filip-we/6502/etc/the_computer_20210620.jpg

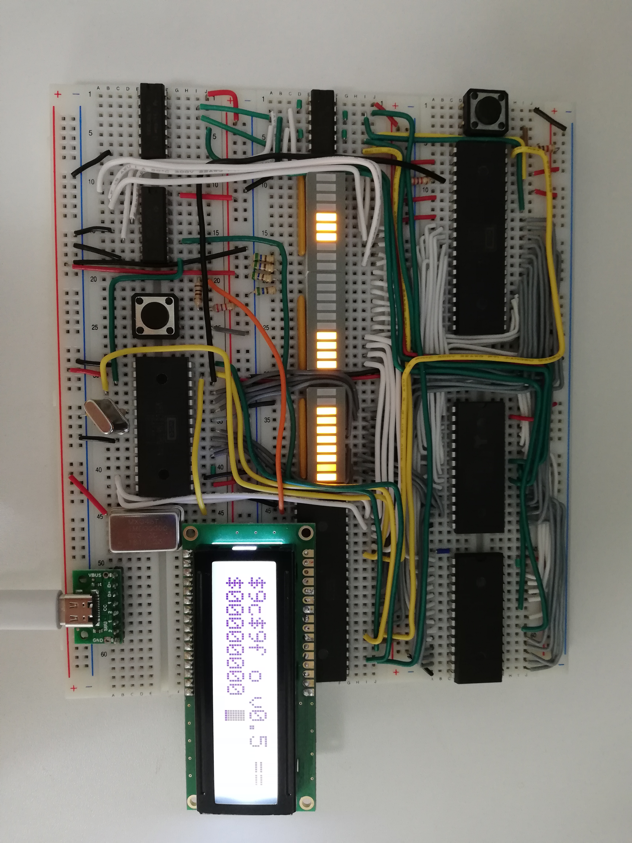
etc/the_computer_20210620.jpg
