filip-we/6502/eeprom/eeprom_prog.png

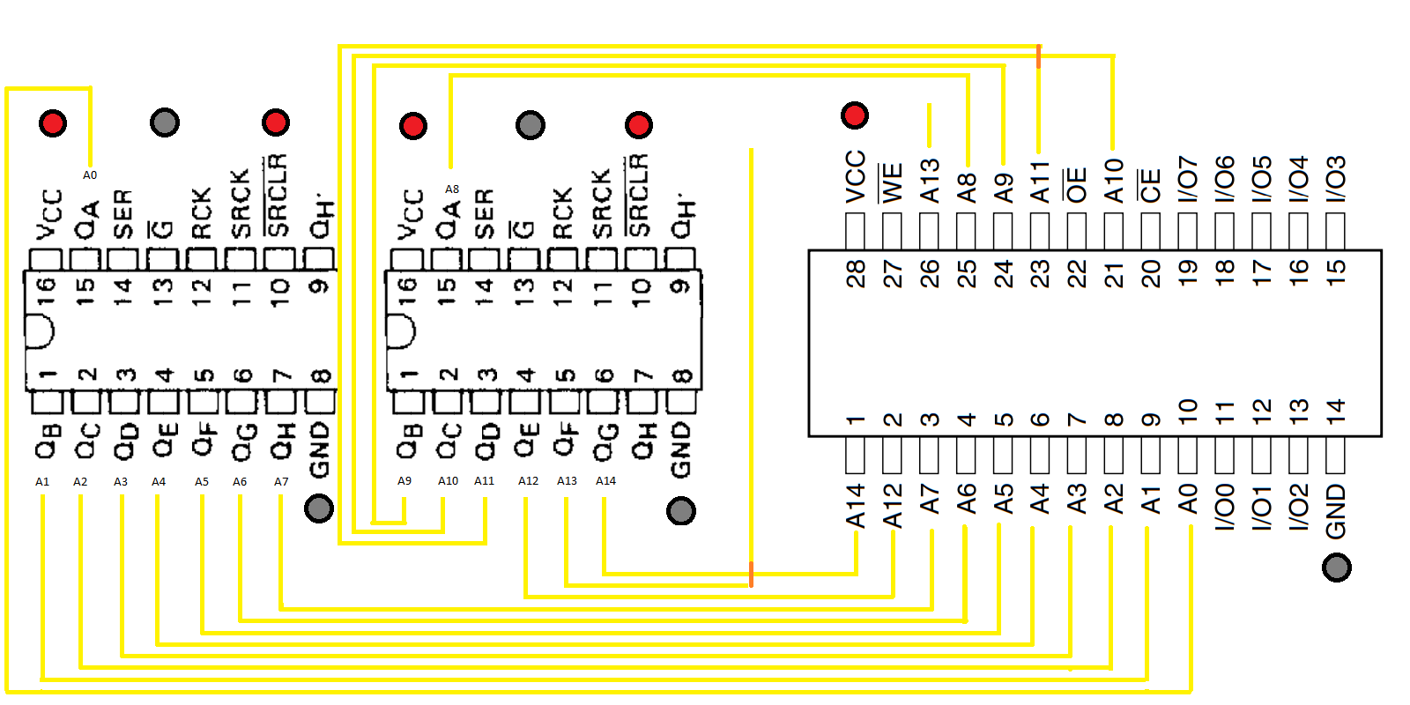
eeprom/eeprom_prog.png
