filip-we/6502/etc/pcb/6502_test/6502_test.kicad_pcb

## KiCad design LM3886_servo.sch

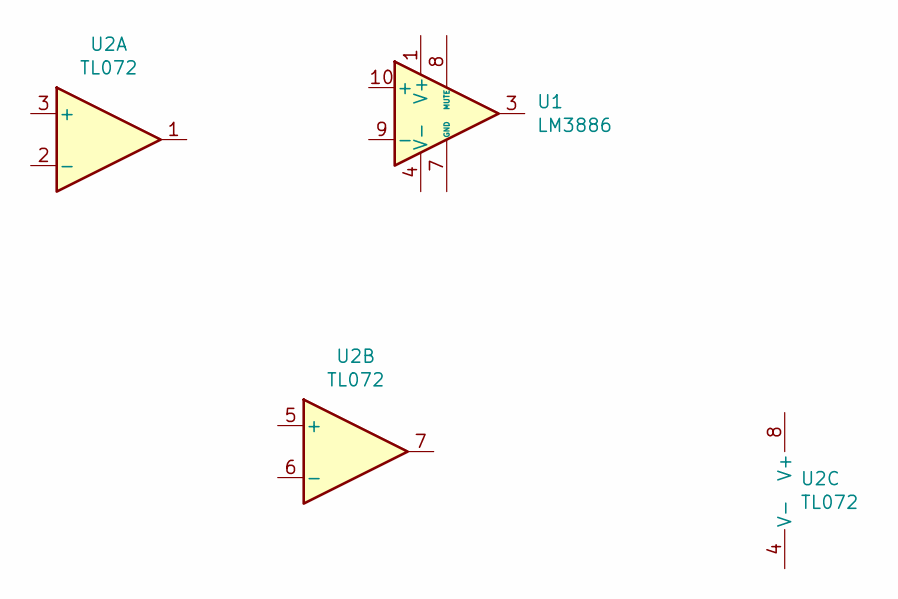
[picture p3: schematic LM3886_servo.sch]

Parts:
U1: LM3886; TO-220-11_P3.4x5.08mm_StaggerOdd_Lead4.85mm_Vertical
U2: TL072

Connections:
unnamed: U1.1 (V+), U1.5 (V+)
