filip-we/6502/eeprom/eeprom_schematic_soldered.png

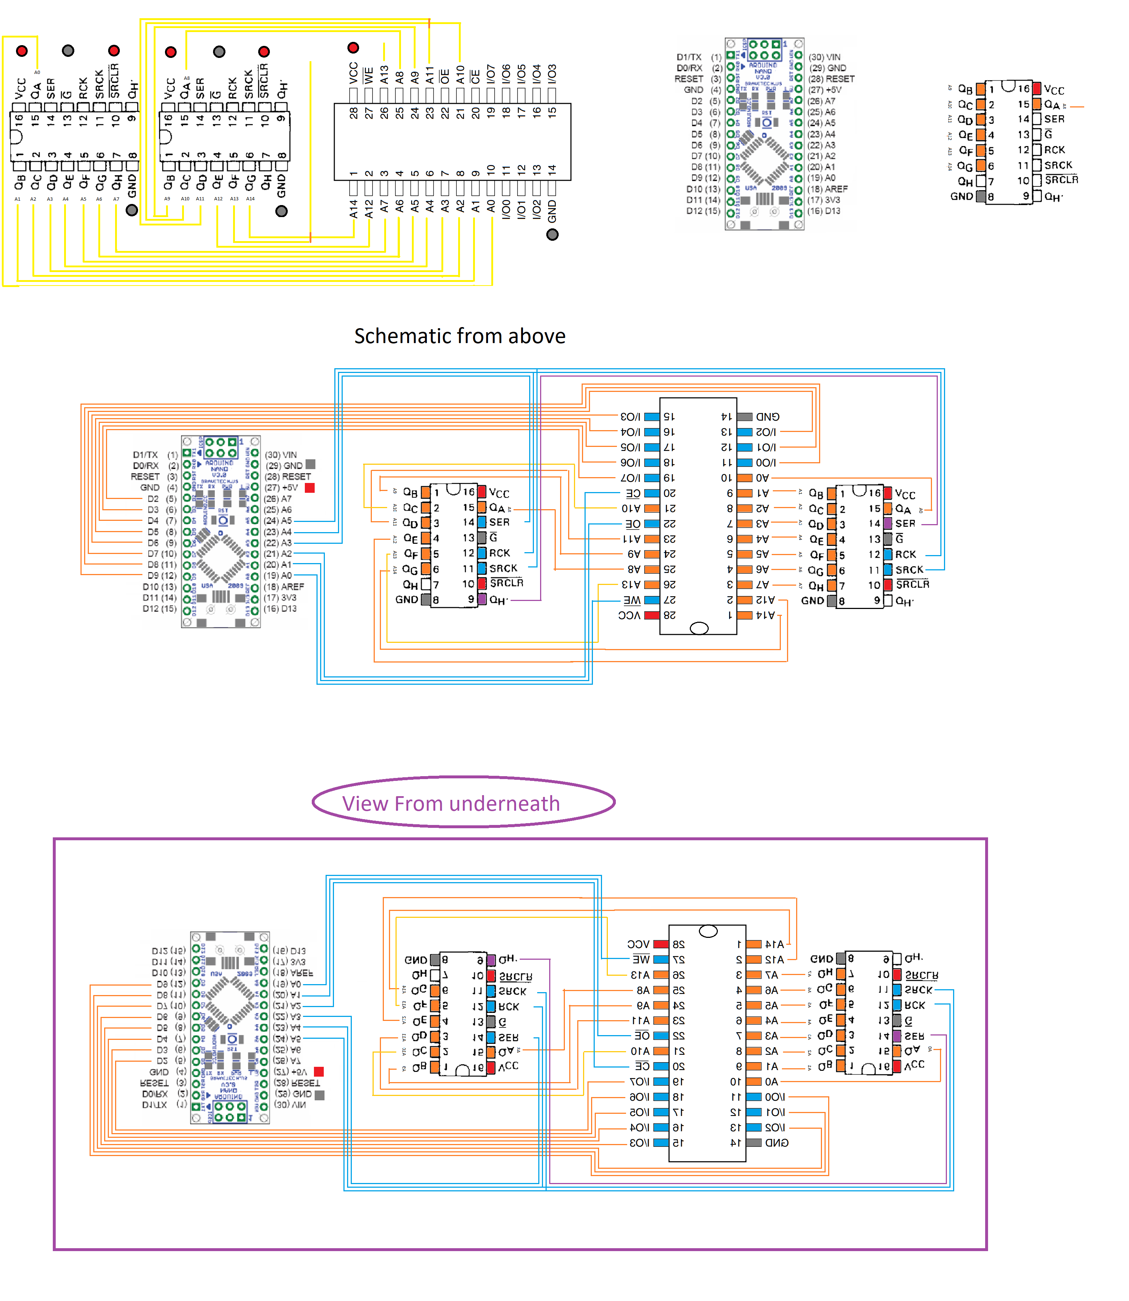
eeprom/eeprom_schematic_soldered.png
