filip-we/6502/(threads)

Thread 1 (2021-01-28):

Network RAM-loader

filip-we, 2021-01-28:
The computer should be able to read data from a PC and write the data into it's RAM. Writing to RAM should be enabled at startup by pulling a special input in the 6522 low (or high). When in "boot-mode" the 6502 will basically just forward any incoming data to the RAM, staring right after zero-page preferably. As a start, the amount of data could be fixed at 128 bytes, but further on some kind of page write could be implemented.

During the reset sequence the MC checks if the "boot-button" is being pressed. If so it jumps to the "Flash ROM-program", stored in EEPROM. When there it will read any incoming bytes from the ACIA and write them to the RAM, staring right after zero-page. The only "statefullness" needed is to keep track on which byte was written last. When byte 128 is written the program just halts.
Restarting in normal mode will boot into RAM, right after zero-page.

Boot-pseudo-code:
```
IF PB7 on 6522 is HIGH:
    jmp RAM_LOADER
ELSE:
    jmp ZERO_PAGE + 1
```

RAM-Loader-pseudo-code:
```
Reset pointer for where in RAM we currently are.
Wait for interrupts.
Interrupt handler:
    If pointer == 128 bytes:
        Exit interrupt.
    Read the new byte from the ACIA.
    Load the RAM-pointer.
    Write the ACIA-byte to the pointer.
    Increase pointer.
```

Hardware needed:
- [x] Button and a pull-up resistor on PB7

filip-we, 2021-09-25:
Scrapping this in favor of using FT245 instead.

Closed 2021-09-25.

Thread 2 (2021-09-18):

Read and debounce multiple keys

filip-we, 2021-09-18:
As of now only one key is being handled. We want to debounce and read all four buttons on the breadboard and put the corresponding characters in the keyboard buffer.

filip-we, 2021-09-18:
Let x be the counter for the keys. It can start at 4 (or 3 depending on when in the routine we update it) and decrease. With every key we decrement x.
- We can read Port A once for every key, it does not take long to do.
- x will allow access to the correct char from the charmap for when a key should be added to the buffer
- x also lets us read and write to the correct key counting-byte

Closed 2021-09-18.

Thread 3 (2021-09-20):

Add PS2-keyboard

filip-we, 2021-09-20:
Add hardware and "firmware" based on Ben's design. We build specialized hardware with the purpose of:
1. Converting the scan-codes from serial to parallel data.
2. Trigger a read only when a full packet of 11 bits have been received. This is done with an RC-circuit and a diode allowing the capacitor to charge quickly (but decharge more slowly).

I am breaking down the work in these steps:
- [ ] Add test code to count pulses. When an NMI happens, increase a counter by one. Print the value of counter in main loop.
- [ ] Setup NAND-gate for the packet-detecting circuit. Try out the resistor so that one keypress gives the expected count of three.
- [ ] Connect two shift registers. Perhaps look at the output in some LED:s
- [ ] Connect the 8 data bits to the 6522 where the LCD and the Arduino Mega is connected. Should be OK as long as you don't use the keyboad while transfering data.

filip-we, 2021-09-26:
I have tried out the resistor value very precisely, down to hundred ohms. The number is 5.25 kOhm using the following resistors:

- 4.9 kOhm
- 560 Ohm
- 82 Ohm
- 10 Ohm

The issue is that despite this it does not count the pulses consistently. With the same key press it can both count to many and too few pulses. Reading the datasheet for the NOT-gate I use did not yield anything. What I later realized when going through everything again was that that chip is TTL logic-levels. This could certainly be the issue here, but of course not guaranteed. I ordered a proper schmitt triggering IC so let's see if that fixes it.

filip-we, 2021-09-26:
I got the idea to add more decoupling capacitors in case that was the issue. When connecting the wires again it of course did not work. But after inverting the data packet-pulse another time it suddenly worked. And it seems to work consistently. I suspect the edge triggering needs to get high-going pulses... but I don't understand why.

filip-we, 2021-10-03:
Changed to use CA1 on VIA2 instead of VIA2 to not accidentally reset the interrupt. There is still problem with reading consecutive scan codes from the keyboard. The first part of the release code often gets corrupted. I've added the startbit, stopbit and paritybit to VIA2 PORTA and check for start and stopbit before reading the scancodes. It is verified to work since permanently tying them to the incorrect level causes no scan codes to be read at all.

filip-we, 2021-10-03:
Updates of the hardware:
- Added VIA at $5000. Registers wired to A0-A3, chip select is wired to the same glue-logic except for one CA that is connected to A12.
- Keyboard databits to PORTA
- Keyboard controlbits to PORTB 0 to 2

filip-we, 2021-10-04:
I have tested with the newly arrived CD40106B, but strange scan codes persist. However, everything works perfect when using another keyboard. Figuring out what's up with the old one can be a project for when I got an oscilloscope or a logic analyzer.
