filip-we/6502/(commit log)

2020-09-24 Big updates.
    Changed pins on Arduino. Fixed protocol bugs.
    [eeprom_friend.ino, eeprom_friend.py, filipro.py]
2020-09-25 Added schematics for eeprom programmer
2020-09-27 Work on soldered eeprom prog.
2020-10-03 RAM upgrade. 7-segment Arduino driver
2020-10-18 PCB design
    [6502_test.kicad_pcb, 6502_test.sch]
2020-10-31 Formatting of assembly-code
2020-10-31 Prototype of CMD-interpretor
2021-01-29 Added boot-mode button code
2021-02-13 Changed compiler to cc65 and refactoring.
    [memory_map.cfg]
2021-02-14 WIP remote memory reading
    [memory_map.cfg]
2021-02-17 Converted print_string subroutine
2021-06-28 WIP reworking memorymap to fit sixty5o2 bootloader
    [memory_map.cfg]
2021-08-31 WIP SPI
2021-09-05 Reading SPI and printing to screen!
2021-09-07 Intermittently working RAM-boot
    [memory_map.cfg]
2021-09-09 Improved hex-print routine
2021-09-09 Added print-string method
2021-09-13 Notes on buttons
2021-09-15 Added framework for button reading and debouncing
2021-09-16 Working timed interrupts from the VIA
2021-09-17 Fixed proper stack preservation on interrupts
2021-09-18 Added multiple buttons, closes #2
2021-09-21 Added pulse counter print
2021-09-26 The big cleaning-operation. Updated Readme.
    [6502_test.kicad_pcb, 6502_test.sch, memory_map.cfg]
2021-10-13 Ps2 keyboard (#5)
    * Added hardware and firmware to interface with PS2-keyboard
    * Recognizing extended scan codes, shift and controll.
    * Renamed variables to lowercase according to convention.
    * Rework of memory map and linker configuration!
    * Fixed minor variable length bugs.
    [memory_map.cfg]
2021-10-14 New memory maps to support putting program on EEPROM. (#7)
    [memory_map_for_rom.cfg, memory_map_for_sixty5o2.cfg]
